SergeiSOficial/icaRUS/README.md

# icaRUS
NB-Fi based Intellectual Custom Apparatus

Tools:
CubeMX
EWARM 8.40.1
VSCode
Altium

Simple air quality monitor

https://habr.com/ru/post/587224/
