SergeiSOficial/icaRUS/hardware/icaRUSv0.2-Параметры платы.xlsx

Размеры платы | X: 84; Y: 84
Механическая обработка: | Фрезерование
Раскладка в панели, плат:
Количество проводящих слоёв: | 2
Сборка (структура слоёв):
Материал основания: | FR4 типовой
Толщина материала, мм: | 1.5
Толщина фольги, мкм: | 35
Финишное покрытие контактн. площадок: | HASL
Наличие маски: | с 2 сторон, красного (глянцевого) цвета
Наличие маркировки краской: | с 2 сторон, белого (типового) цвета;
Вид переходных отверстий: | Закрыты маской
