SergeiSOficial/icaRUS/hardware/icaRUSv0.2/icaRUSv0.2.xlsx

Designator | PartNumber | Comment | Description | Quantity
C1, C5, C7, C14, C23, C41, C51, C52, C53, C54, C55 | CC0402KRX5R5BB475 | 4.7u 6.3V | CAP CER 4.7UF 6.3V X5R 0402 | 11
C2, C4, C6, C8, C9, C10, C13, C17, C18, C20, C56, C57 | CC0402KRX5R7BB105 | 1u 16V | CAP CER 1UF 16V X5R 0402 | 12
C3, C12, C15, C19, C21, C25, C26, C28, C39, C42, C43, C44, C45, C47, C48 | CC0402KRX7R7BB104 | 0.1u 16V | CERCAP 0.1/16V 0402 KX7R | 15
C11, C16, C22 | CC0402KRX7R8BB104 | 0.1u 25V | CAP CER 0.1UF 25V X7R 0402 | 3
C24 | 0402N102F500LT | 1000p 50V | CAP CER 1000PF 1% 50V C0G/NPO 0402 | 1
C27 | CC0402BRNPO9BN1R2 | 1.2p 50V | CAP CER 1.2PF 50V NPO 0402 | 1
C29, C32, C40, C46 | CC0402JRNPO9BN101 | 100p 50V | CAP CER 100PF 50V C0G/NPO 0402 | 4
C30, C31, C33, C35, C37 | CC0402BRNPO9BN2R7 | 2.7p 50V | CAP CER 2.7PF 50V C0G/NPO 0402, CAP CER 2.7pF 50V NPO 0402 | 5
C34 | CC0402CRNPO9BN6R2 | 6.2p 50V | CAP CER 6.2PF 50V NPO 0402 | 1
C36 | CC0402BRNPO9BN3R6 | 3.6p 50V | CAP CER 3.6PF 50V NPO 0402 | 1
C38 | CC0402BRNPO9BN1R5 | 1.5p 50V | CAP CER 1.5PF 50V NPO 0402 | 1
C49, C50 | CC0402JRNPO9BN200 | 20p 50V | CAP CER 20PF 50V C0G/NPO 0402 | 2
D1 | SWS1470-A0 QFN32 | SWS1470-A0 QFN32 | Waviot NB-Fi RF Transceiver QFN32 | 1
DA1 | NCP502SQ18T2G | NCP502SQ18T2G | IC REG LINEAR 1.8V 80MA SC88A | 1
DA2 | BGS12WN6E6327XTSA1 | BGS12WN6E6327XTSA1 | RF Switch IC WLAN SPDT 50Ohm PG-TSNP-6-10 | 1
DD1 | STM32L412KBUx | STM32L412K8Ux | ARM® Cortex®-M4 CPU with FPU, STM32L4 Microcontroller IC 32-Bit 80MHz 64KB (64K x 8) FLASH 32-UFQFPN (5x5) | 1
GB1 | LP753440 | 3.7V 1000mAh | LiPoly Battery LP753440 3.7V 1000mAh with PCM | 1
HL1, HL2 | FYLS-0603URC | RED | LED Red 0603 | 2
J1 |  | 61300111121 | THT Vertical Pin Header WR-PHD, Pitch 2.54 mm, Single Row, 1 pins | 1
L1, L2, L3 | BLM15PD121SZ1D | 120R 1.3A | FERRITE BEAD 120 OHM 0402 1LN | 3
L4, L5, L6, L7 | LQW15AN82NG00D | 82nH | FIXED IND 82NH 130MA 2.24 OHM | 4
L8, L11, L12, L13 | LQW15AN12NG00D | 12nH | FIXED IND 12NH 500MA 140 MOHM | 4
L9, L10 | LQW15AN10NG00D | 10nH | FIXED IND 10NH 500MA 170 MOHM | 2
R1 | RC0402FR-072ML | 2M 1% | RES SMD 2M OHM 1% 1/16W 0402 | 1
R2, R3, R7 | RC0402FR-071ML | 1M 1% | RES SMD 1M OHM 1% 1/16W 0402 | 3
R4, R6 | RC0603FR-07470RL | 470R 1% | RES 0603 470R 1% | 2
R5 | RC0402JR-0710KL | 10k 5% | RES SMD 10k OHM 5% 1/16W 0402 | 1
R8, R9, R13, R14, R15 | RC0402FR-0710KL | 10k 1% | RES SMD 10K OHM 1% 1/16W 0402 | 5
R10, R11 | RC0402FR-071KL | 1k 1% | RES SMD 1K OHM 1% 1/16W 0402 | 2
R12 | RC0402FR-071RL | 1R 1% | RES SMD 1 OHM 1% 1/16W 0402 | 1
SB1 |  | Jumper Solder | Jumper Solder | 1
SW1 |  | EVQ-P7J01P | Tactile Switch SPST-NO Side Actuated Surface Mount, Right Angle | 1
U1 |  | BME280 | Combined Humidity and Pressure Sensor, 1.71 to 3.6 V, -40 to 85 degC, 8-Pin SMD, RoHS, Tape and Reel | 1
U2 |  | SGP30 | The SGP30 is a digital multi-pixel gas sensor designed for easy integration into air purifier, demand-controlled ventilation, and IoT applications. | 1
U3 |  | MCP73831T-2ATI/OT | Charger IC Lithium Ion/Polymer SOT-23-5 | 1
U4 |  | ESDA5V3SC6 | Clamp Ipp Tvs Diode Surface Mount SOT-23-6 | 1
VD1, VD2, VD3 | RB520S30 | RB520S30 | RECTIFIER DIODE, SCHOTTKY, 0.2A | 3
VR1 | H7605-18MR | H7605-18MR | Voltage Regulator H7605-18MR | 1
VT1 | PDTC143ZE | PDTC143ZE | SMALL SIGNAL BIPOLAR TRANSISTOR | 1
VT2 | PMF170XP | PMF170XP | MOSFET P-CH 20V 1A SOT323 | 1
VT3 | FDV303N | FDV303N | MOSFET N-CH 25V 680MA SOT-23 | 1
X1 | PLS-5 | PLS-5 | PLS-5-2.54 | 1
X2 | 1981568-1 | 1981568-1 | CONN RCPT USB2.0 MICRO B SMD R/A | 1
ZQ1 | NT2016SA-26.000000MHZ-NBG2 | 26MHz 2ppm | TCXO Oscillator 4-pin | 1
ZQ2 | NX3215SA-32.768K-EXS00A | 32.768 kHz | CRYSTAL 32.768KHZ 12.5PF SMD | 1
