SergeiSOficial/icaRUS/hardware/icarusSCH.pdf

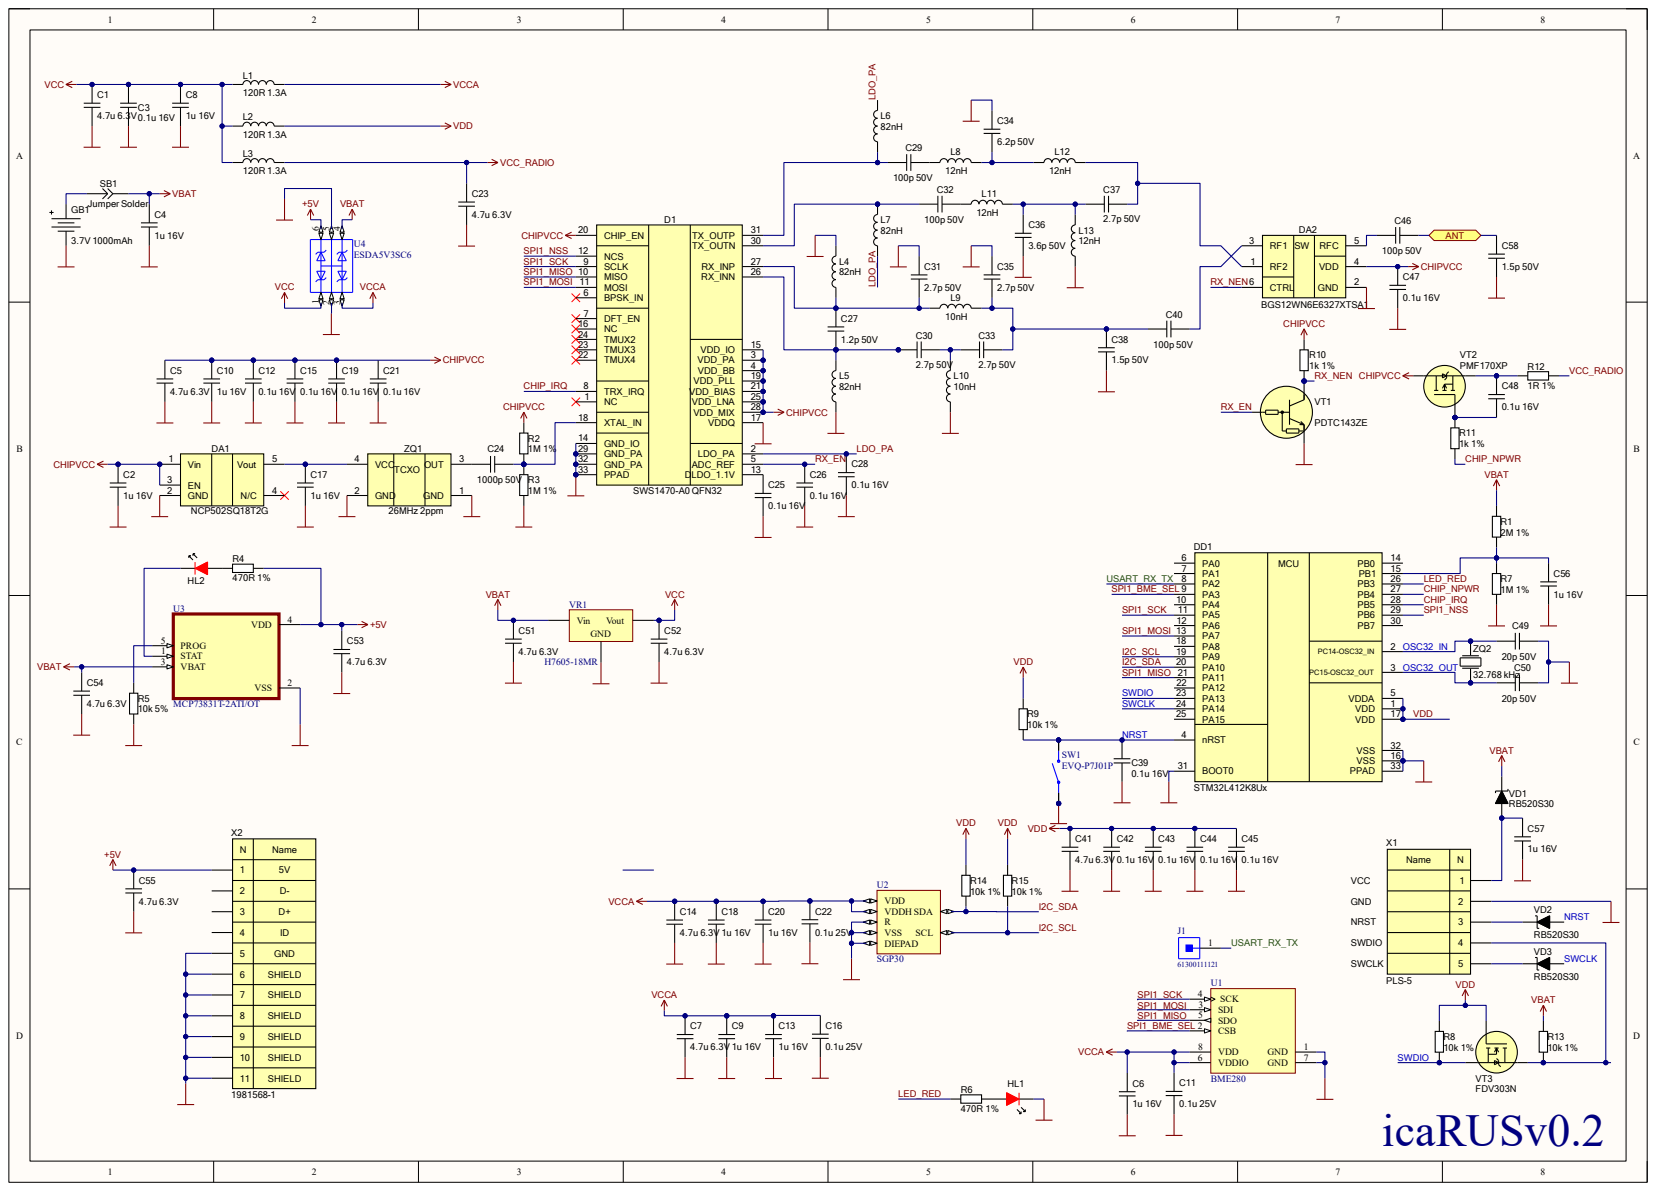
[picture p1: page 1]
