SergeiSOficial/icaRUS/(list of files, drawings)

Other design files:
hardware/icaRUSv0.2/icaRUSv0.2.PrjPcb
hardware/icaRUSv0.2/icaRUSv0.2.SchDoc
