SergeiSOficial/icaRUS/firmware/Src/main.c

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
/* Includes ------------------------------------------------------------------*/
#include "main.h"
#include "crc.h"
#include "i2c.h"
#include "iwdg.h"
#include "rtc.h"
#include "spi.h"
#include "gpio.h"

/* USER CODE BEGIN Includes */
#include "cb.h"
#include "radio.h"
#include "WVT_BME280.h"
#include "WVT_SGP40.h"
/* USER CODE END Includes */


/* USER CODE BEGIN PV */
water7_params_str *Water7_params_p;
/*!
 * \brief
 * \todo check this
 */
main_par_t main_par =
{
  MODE_TEST,0,0,0
};
/*!
 * \brief every second scheduler descriptor
 *
 */
struct scheduler_desc everysec_desc;
/*!
 * \brief measurement on BME280 scheduler descriptor
 *
 */
struct scheduler_desc meas_desc;

bool WeCanSleep = false;
/* USER CODE END PV */

void SystemClock_Config(void);
/* USER CODE BEGIN 0 */
/*!
 * \brief set water7 protocol and meter configuration
 *
 */
void waterAndMeterInit(void)
{
  water7_params_str *water7_params_p = Water7GetParams();
  meter_params_str *meter_params_p = 0;
  /// \todo fix this
  get_saved_param(water7_params_p, meter_params_p);

  Water7PushFunc(WATER7_FUNC_SET_DATA, water7set_data);
  Water7PushFunc(WATER7_FUNC_GET_DATA, water7get_data);
  Water7PushFunc(WATER7_FUNC_SAVE_DATA, water7save_data);
  Water7PushFuncRfl(WATER7_FUNC_RFL, water7_rfl);

  Water7Init(water7_params_p);
  /// \todo fix this
  meter_init(meter_params_p, meter_inc_cb);
  Water7SendEvent(EVENT_RESET, 0);
}

/*!
 * \brief every wakeup tick
 *
 * \param desc
 */
void EverySec(struct scheduler_desc *desc)
{
    time_t timeNow = RTC_GetSeconds();
    Water7OneSec(RTC_GetTime());
}

/*!
 * \brief send complete callback from nb-fi
 *
 * \param ul
 */
void nbfi_send_complete(nbfi_ul_sent_status_t ul)
{
}

/*!
 * \brief receive complete callback from nb-fi
 *
 * \param data
 * \param length
 */
void nbfi_receive_complete(uint8_t *data, uint16_t length)
{
    Water7RXcallback(data, length);
}
/* USER CODE END 0 */

/**
  * @brief  The application entry point.
  * @retval int
  */
int main(void)
{
  /* USER CODE BEGIN 1 */
#ifdef DEBUG
//    LL_DBGMCU_EnableDBGStopMode();
#endif
  /* USER CODE END 1 */

  /* MCU Configuration--------------------------------------------------------*/

  /* Reset of all peripherals, Initializes the Flash interface and the Systick. */
  HAL_Init();

  /* Configure the system clock */
  SystemClock_Config();

  /* Initialize all configured peripherals */
  MX_GPIO_Init();
  MX_CRC_Init();
  MX_RTC_Init();
  MX_SPI1_Init();
  MX_IWDG_Init();
  MX_I2C1_Init();
  /* USER CODE BEGIN 2 */
  IWDG_Init();
  /* Ensure that MSI is wake-up system clock */
  LL_RCC_SetClkAfterWakeFromStop(LL_RCC_STOP_WAKEUPCLOCK_MSI);

  //LL_PWR_EnableLowPowerRunMode();

  GPIO_Wa1470_WriteCs(0);//ensure that we disable wa1470 chip select
  SPI_Activate(); //enable SPI
  radio_init(); //Init radio NB-Fi and timers
  waterAndMeterInit(); // Init protocol for NB-Fi
  scheduler_add_task(&everysec_desc, EverySec, RUN_CONTINUOSLY_RELATIVE, SECONDS(30)); //should not exceed 30 seconds, because need to reset the watchdog

  WVT_BME280_Init();
  WVT_SGP40_Init();
  /* USER CODE END 2 */

  /* Infinite loop */
  /* USER CODE BEGIN WHILE */
  while (1)
  {
    /* USER CODE END WHILE */

    /* USER CODE BEGIN 3 */
    scheduler_run_callbacks();//need check timers
    NBFI_Main_Level_Loop(); 
    IWDG_Refresh();
    if (NBFi_can_sleep() && scheduler_can_sleep() && Water7isCanSleep())
    {
      GPIO_Wa1470_WriteCs(0); //disable chip select pin to ensure that no high level on input pin WA1470
      HAL_PWR_EnterSTOPMode(PWR_LOWPOWERREGULATOR_ON, PWR_STOPENTRY_WFI);
    }
    //      HAL_PWR_EnterSLEEPMode(PWR_LOWPOWERREGULATOR_ON, PWR_SLEEPENTRY_WFI);
  }
  /* USER CODE END 3 */
}

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
