SergeiSOficial/icaRUS/firmware/Inc/main.h

#define HW_VERSION ((uint32_t)0)
#define HW_SUB_VERSION ((uint32_t)1)
#define FW_VERSION ((uint32_t)1)
#define FW_SUB_VERSION ((uint32_t)7)
#define BAND UL868800_DL869150 //	RU
#define SPI_TIMEOUT 50000
#define MS_IN_SECOND 1000
#define MAX_TIMEOUT 10000
#define SPI1_BME_SEL_Pin LL_GPIO_PIN_3
#define SPI1_BME_SEL_GPIO_Port GPIOA
#define LED_RED_Pin LL_GPIO_PIN_3
#define LED_RED_GPIO_Port GPIOB
#define WA_CHIP_EN_Pin LL_GPIO_PIN_4
#define WA_CHIP_EN_GPIO_Port GPIOB
#define WA_IRQ_Pin LL_GPIO_PIN_5
#define WA_IRQ_GPIO_Port GPIOB
#define WA_IRQ_EXTI_IRQn EXTI9_5_IRQn
#define SPI1_NSS_Pin LL_GPIO_PIN_6
#define SPI1_NSS_GPIO_Port GPIOB
