SergeiSOficial/icaRUS/firmware/Src/NBFiHAL/radio.c

#include "defines.h"
#include "radio.h"
#include "radio.h"
#include "spi.h"
#include "WVT_EEPROM.h"
#include "update.h"

#define MODEM_ID_AND_KEY_ADD    0x0801ff80

#define MODEM_ID  ((uint32_t *)MODEM_ID_AND_KEY_ADD)
#define KEY  ((uint32_t *)(MODEM_ID_AND_KEY_ADD+4))

#define BLOCK_SIZE 0x800

#define SR_SERVER_MODEM_ID_AND_KEY_ADD    0x20001000

nbfi_device_id_and_key_st sr_server_modem_id_and_key @SR_SERVER_MODEM_ID_AND_KEY_ADD;

#define SR_SERVER_MODEM_ID_PTR  ((uint32_t *)SR_SERVER_MODEM_ID_AND_KEY_ADD)
#define SR_SERVER_KEY_PTR  ((uint32_t *)(SR_SERVER_MODEM_ID_AND_KEY_ADD + 4))


#define MANUFACTURER_ID 0x8888 //Waviot
#define HARDWARE_TYPE_ID 0x37   //Aqua3
#define PROTOCOL_ID 11          //undefined
#define TX_MAX_POWER 15
#define TX_MIN_POWER -13
#define SEND_INFO_PERIOD 2592000 //one time per month

#define BAND         UL868800_DL869150          //RU


#if BAND == UL868800_DL446000
#define NBFI_UL_FREQ_BASE       868800000
#define NBFI_DL_FREQ_BASE       446000000
#elif BAND == UL868800_DL864000
#define NBFI_UL_FREQ_BASE       868800000
#define NBFI_DL_FREQ_BASE       864000000
#elif BAND == UL868800_DL446000_DL864000
#define NBFI_UL_FREQ_BASE       868800000
#define NBFI_DL_FREQ_BASE       864000000
#elif BAND == UL867950_DL446000
#define NBFI_UL_FREQ_BASE       867950000
#define NBFI_DL_FREQ_BASE       446000000
#elif BAND == UL868500_DL446000
#define NBFI_UL_FREQ_BASE       868500000
#define NBFI_DL_FREQ_BASE       446000000
#elif BAND == UL868100_DL446000
#define NBFI_UL_FREQ_BASE       868100000
#define NBFI_DL_FREQ_BASE       446000000
#elif BAND == UL864000_DL446000
#define NBFI_UL_FREQ_BASE       864000000
#define NBFI_DL_FREQ_BASE       446000000
#elif BAND == UL863175_DL446000
#define NBFI_UL_FREQ_BASE       863175000
#define NBFI_DL_FREQ_BASE       446000000
#elif BAND == UL864000_DL875000
#define NBFI_UL_FREQ_BASE       864000000
#define NBFI_DL_FREQ_BASE       875000000
#elif BAND == UL868800_DL868000
#define NBFI_UL_FREQ_BASE       868800000
#define NBFI_DL_FREQ_BASE       868800000
#elif BAND == UL868800_DL869150                 //RU
#define NBFI_UL_FREQ_BASE       868800000
#define NBFI_DL_FREQ_BASE       869150000
#elif BAND == UL868100_DL869500
#define NBFI_UL_FREQ_BASE       868100000       //EU
#define NBFI_DL_FREQ_BASE       869500000
#elif BAND == UL866900_DL865100
#define NBFI_UL_FREQ_BASE       866900000       //IN
#define NBFI_DL_FREQ_BASE       865100000
#elif BAND == UL864000_DL863500
#define NBFI_UL_FREQ_BASE       864000000       //KZ
#define NBFI_DL_FREQ_BASE       863500000
#elif BAND == UL458550_DL453800
#define NBFI_UL_FREQ_BASE       458550000       //UZ
#define NBFI_DL_FREQ_BASE       453800000
#elif BAND == UL916500_DL903000
#define NBFI_UL_FREQ_BASE       916500000       //ARG
#define NBFI_DL_FREQ_BASE       903000000
#endif


#define TRY_LOW_PHY_ALTERNATIVE   {4, UL_DBPSK_50_PROT_E, DL_DBPSK_50_PROT_D, NBFI_UL_FREQ_PLAN_NO_CHANGE + NBFI_DL_FREQ_PLAN_NO_CHANGE}
#define TRY_MINIMAL_UL_BAND_AND_LOW_PHY_ALTERNATIVE   {8, UL_DBPSK_50_PROT_E, DL_DBPSK_50_PROT_D, NBFI_FREQ_PLAN_MINIMAL + NBFI_DL_FREQ_PLAN_NO_CHANGE}


const nbfi_settings_t nbfi_default_settings =
{
    MODEM_ID,
    KEY,
    DRX,                //mode;
    UL_DBPSK_50_PROT_E, // tx_phy_channel;
    DL_DBPSK_50_PROT_D, // rx_phy_channel;
    HANDSHAKE_SIMPLE,
    MACK_1,             //mack_mode
    0,                  //num_of_retries;
    8,                  //max_payload_len;
    0,                  //wait_ack_timeout
    0,                  //tx_freq;
    0,                  //rx_freq;
    PCB,                //tx_antenna;
    PCB,                //rx_antenna;
    TX_MAX_POWER,       //tx_pwr;
    60 * 24 * 7,               //heartbeat_interval
    255,                //heartbeat_num
    0,                  //additional_flags
    NBFI_UL_FREQ_BASE,
    NBFI_DL_FREQ_BASE,
    NBFI_UL_FREQ_PLAN_51200_0 + NBFI_FREQ_PLAN_MINIMAL,
    {
      NBFI_VOID_ALTERNATIVE,
      NBFI_VOID_ALTERNATIVE,
      NBFI_VOID_ALTERNATIVE,
      NBFI_VOID_ALTERNATIVE
    }
};


const nbfi_dev_info_t nbfi_info = {TX_MIN_POWER, TX_MAX_POWER, MANUFACTURER_ID, HARDWARE_TYPE_ID, PROTOCOL_ID, BAND, SEND_INFO_PERIOD};


const nbfi_settings_t nbfi_short_range_settings_server =
{
    MODEM_ID,
    KEY,
    CRX,                   //mode;
    DL_DBPSK_25600_PROT_D, // tx_phy_channel;
    DL_DBPSK_25600_PROT_D, // rx_phy_channel;
    HANDSHAKE_SIMPLE,
    MACK_1,             //mack_mode
    0,                  //num_of_retries;
    8,                  //max_payload_len;
    120,                //wait_ack_timeout
    0,                  //tx_freq;
    0,                  //rx_freq;
    PCB,                //tx_antenna;
    PCB,                //rx_antenna;
    TX_MAX_POWER,       //tx_pwr;
    0,                  //heartbeat_interval
    0,                  //heartbeat_num
    NBFI_FLG_FIXED_BAUD_RATE|NBFI_FLG_SHORT_RANGE_CRYPTO|NBFI_FLG_NO_RESET_TO_DEFAULTS|NBFI_FLG_NO_SENDINFO|NBFI_FLG_NO_REDUCE_TX_PWR,                  //additional_flags
    NBFI_UL_FREQ_BASE,
    NBFI_DL_FREQ_BASE,
    NBFI_FREQ_PLAN_MINIMAL + NBFI_DL_FREQ_PLAN_819200_M2457600,
    {
      NBFI_VOID_ALTERNATIVE,
      NBFI_VOID_ALTERNATIVE,
      NBFI_VOID_ALTERNATIVE,
      NBFI_VOID_ALTERNATIVE
    }
};


const nbfi_settings_t nbfi_short_range_settings_client =
{
    SR_SERVER_MODEM_ID_PTR,
    SR_SERVER_KEY_PTR,
    CRX,                   //mode;
    DL_DBPSK_25600_PROT_D, // tx_phy_channel;
    DL_DBPSK_25600_PROT_D, // rx_phy_channel;
    HANDSHAKE_SIMPLE,
    MACK_1,             //mack_mode
    2,                  //num_of_retries;
    8,                  //max_payload_len;
    150,                //wait_ack_timeout
    0,                  //tx_freq;
    0,                  //rx_freq;
    PCB,                //tx_antenna;
    PCB,                //rx_antenna;
    TX_MAX_POWER,       //tx_pwr;
    0,                  //heartbeat_interval
    0,                  //heartbeat_num
    NBFI_FLG_SHORT_RANGE_CRYPTO|NBFI_FLG_FIXED_BAUD_RATE|NBFI_FLG_NO_RESET_TO_DEFAULTS|NBFI_FLG_NO_SENDINFO|NBFI_FLG_NO_REDUCE_TX_PWR,                  //additional_flags
    NBFI_UL_FREQ_BASE,
    NBFI_DL_FREQ_BASE,
    NBFI_FREQ_PLAN_MINIMAL + NBFI_DL_FREQ_PLAN_819200_M2457600,
    {
      NBFI_VOID_ALTERNATIVE,
      NBFI_VOID_ALTERNATIVE,
      NBFI_VOID_ALTERNATIVE,
      NBFI_VOID_ALTERNATIVE
    }
};

#ifdef DEBUG
void radio_ResetMemoryToZero(void);
#endif //DEBUG

void radio_switch_to_from_short_range(_Bool en, _Bool client_or_server)
{
    nbfi_crypto_iterator_t it = {0,0};
    NBFi_switch_to_custom_settings(client_or_server?((nbfi_settings_t *)&nbfi_short_range_settings_client):((nbfi_settings_t *)&nbfi_short_range_settings_server), &it, en);
}



#define EEPROM_INT_aux_modem_data (DATA_EEPROM_BASE + 1024*5 + 128)

void radio_load_id_and_key_of_sr_server(nbfi_device_id_and_key_st *data)
{
    /// \todo fix thi s
	//memcpy((void*)data, ((const void*)EEPROM_INT_aux_modem_data), sizeof(nbfi_device_id_and_key_st));
}

void radio_save_id_and_key_of_sr_server(nbfi_device_id_and_key_st *data)
{
    /// \todo fix this
//    if(HAL_FLASHEx_DATAEEPROM_Unlock() != HAL_OK) return;
//    for(uint8_t i = 0; i != sizeof(nbfi_device_id_and_key_st); i++)
//    {
//	if(HAL_FLASHEx_DATAEEPROM_Program(FLASH_TYPEPROGRAMDATA_BYTE, EEPROM_INT_aux_modem_data + i, ((uint8_t *)data)[i]) != HAL_OK) break;
//    }
//    HAL_FLASHEx_DATAEEPROM_Lock();
}


void radio_init(void)
{
#ifdef DEBUG
    radio_ResetMemoryToZero();
#endif //DEBUG
        scheduler_HAL_init();
        wa1470_HAL_reg_data_received_callback((void*)NBFi_MAC_RX_ProtocolD);
        wa1470_HAL_reg_tx_finished_callback((void*)NBFi_RF_TX_Finished);
        wa1470_HAL_init();
	nbfi_HAL_init(&nbfi_default_settings, (nbfi_dev_info_t*)&nbfi_info);
        scheduler_run_callbacks();
        NBFi_clear_Saved_Configuration(); //if you need to clear previously saved nbfi configuration in EEPROM
}

#ifdef DEBUG
void radio_ResetMemoryToZero(void)
{
}
#endif //DEBUG
