SergeiSOficial/icaRUS/(commit log)

2021-11-15 Init commit
    [icaRUSv0.2-Параметры платы.xlsx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]
2021-11-17 Add schematic pdf
