SergeiSOficial/icaRUS/(notices)

Notices in the files:
firmware/Inc/main.h:
© Copyright (c) 2020 STMicroelectronics.
All rights reserved.
